klaasdc/arduino-gameshield/README.md

arduino-gameshield
==================

Code and schematics for the inexpensive Arduino Gameshield

https://sites.google.com/site/klaasdc/arduino-projects/arduino-game-console-v2
