klaasdc/arduino-gameshield/poster.png

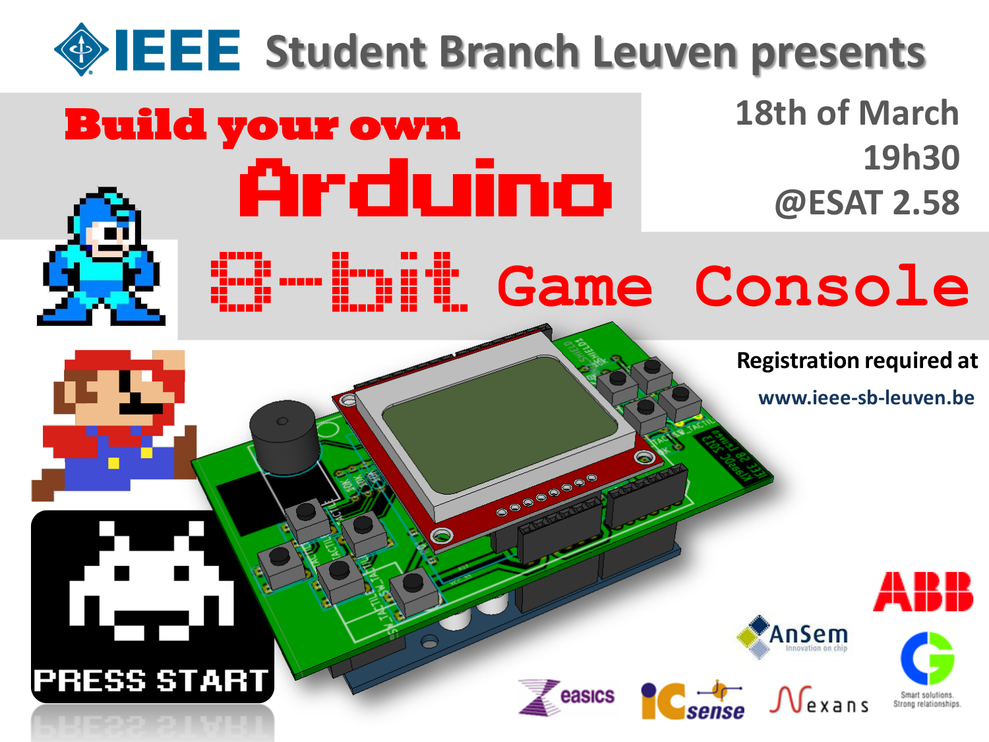
poster.png
