klaasdc/arduino-gameshield/schematics/arduino_shield_pcb1.pdf

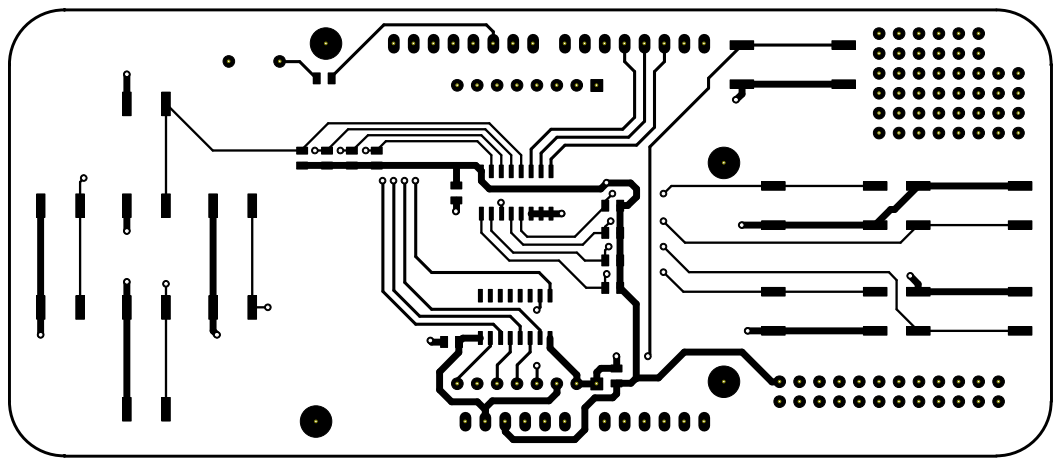
[picture p10: page 1]

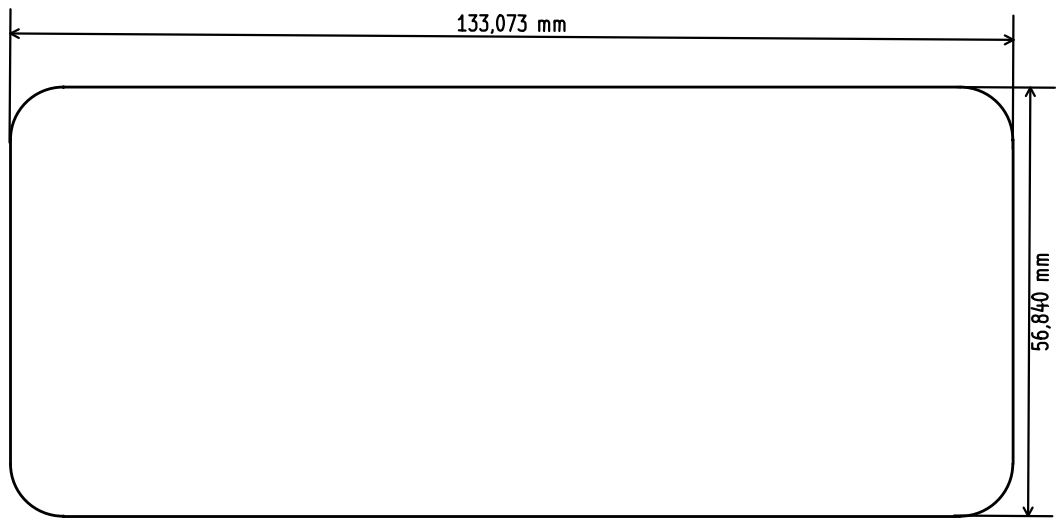
[picture p11: page 2]

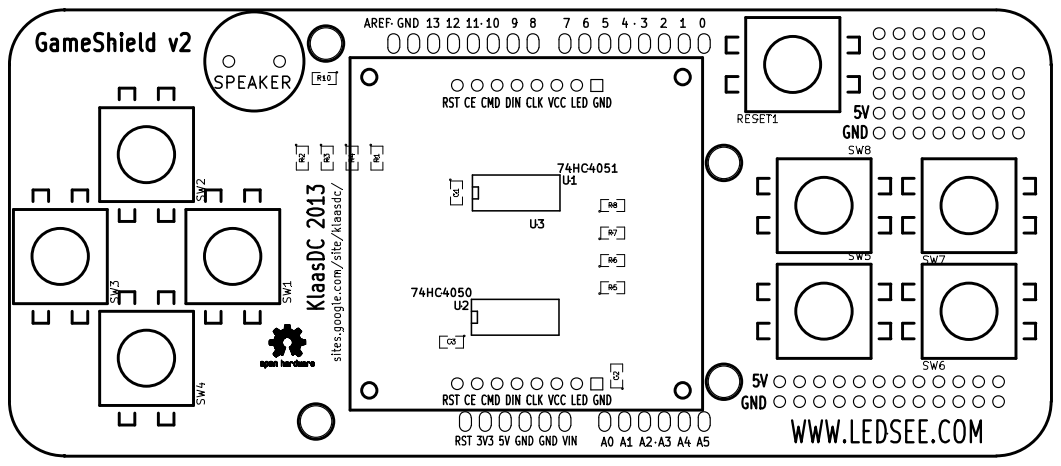
[picture p12: page 3]
