klaasdc/arduino-gameshield/schematics/arduino_shield_schematic.pdf

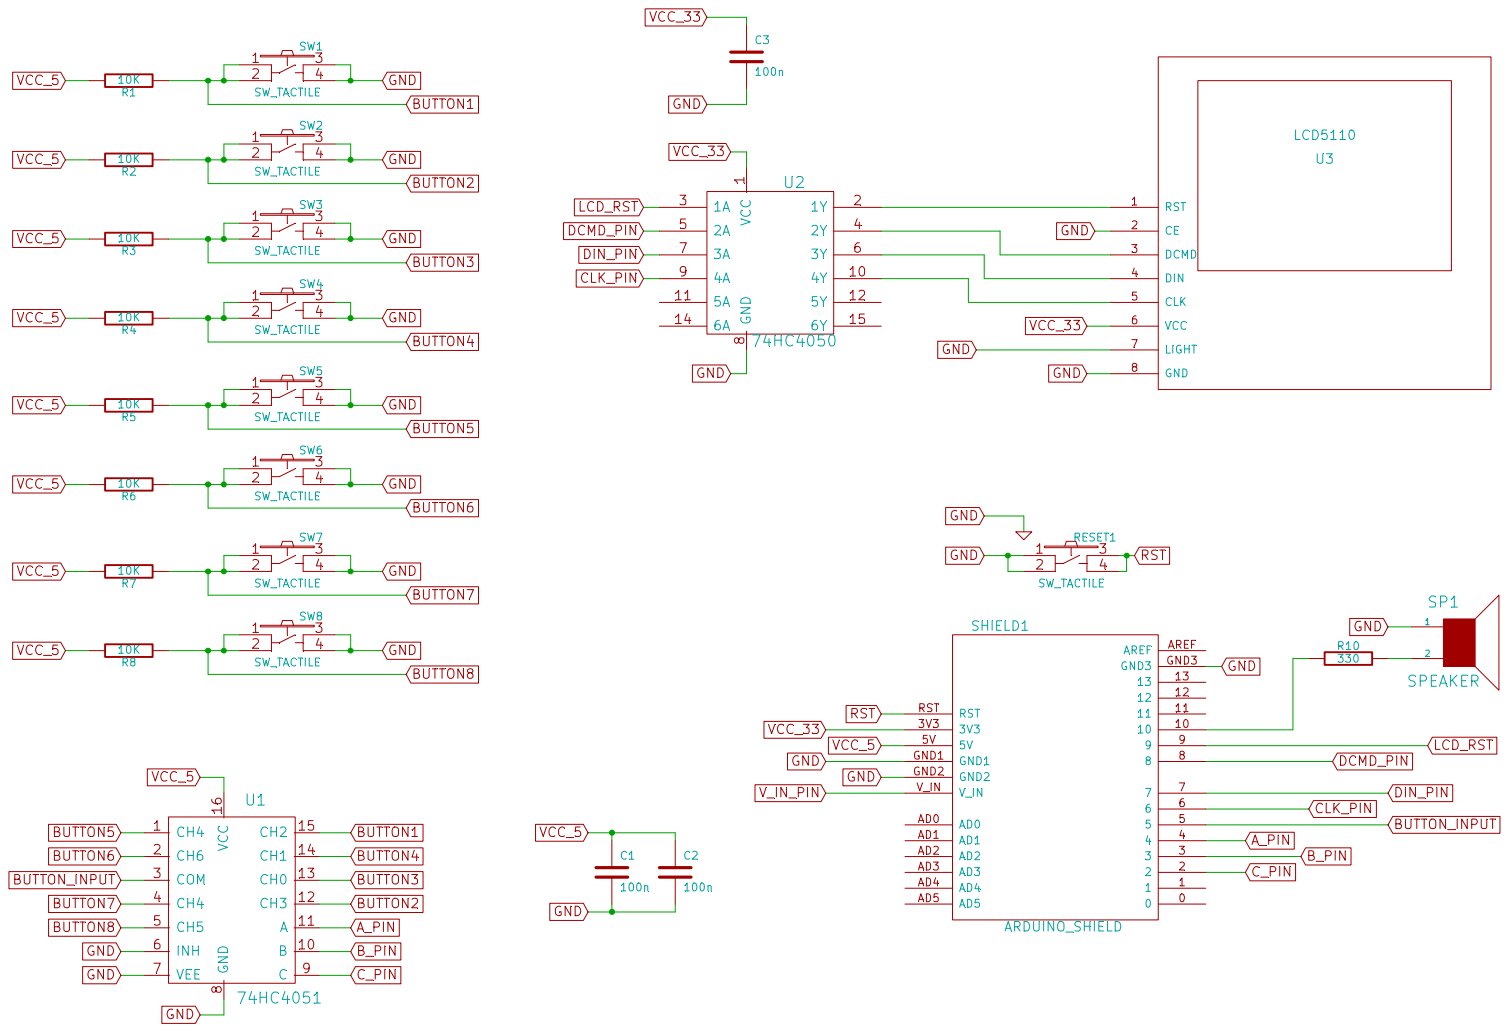
[picture p13: page 1]
